VoronDesign/voron-chariot/README.md

# Voron Chariot



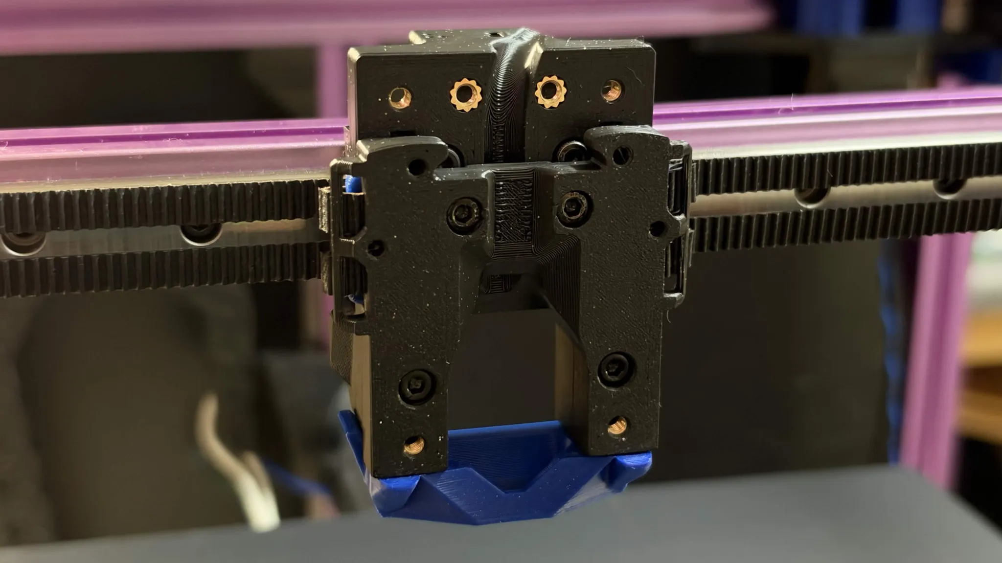
[picture p1: voron_chariot_1.png]
Image of Voron Chariot


The official release of Voron Chariot. You can find the Bill of Materials located [here](BOM.md).

Voron Logo
