VoronDesign/voron-chariot/BOM.md

# Chariot BOM

## Hardware

14 x Brass heat inserts (16 if using BTT Eddy or PINDA)

1 x 100mmx2.5mm Cable/Zip ties

1 x M2x10mm SHCS Self Tapping

2 x M3x6mm BHCS

4 x M3x8mm BHCS (2 if using low profile screws from probe kit)

8 x M3x8mm SHCS

4 x M3x16mm SHCS

2 x M3x20mm BHCS (Only used for BTT Eddy and PINDA)

2 x M3x30mm SHCS

2 x Makerbeam XL T slot nut

2 x M3 Washer

#
