VoronDesign/voron-chariot/CAD/chariot_assembly.step

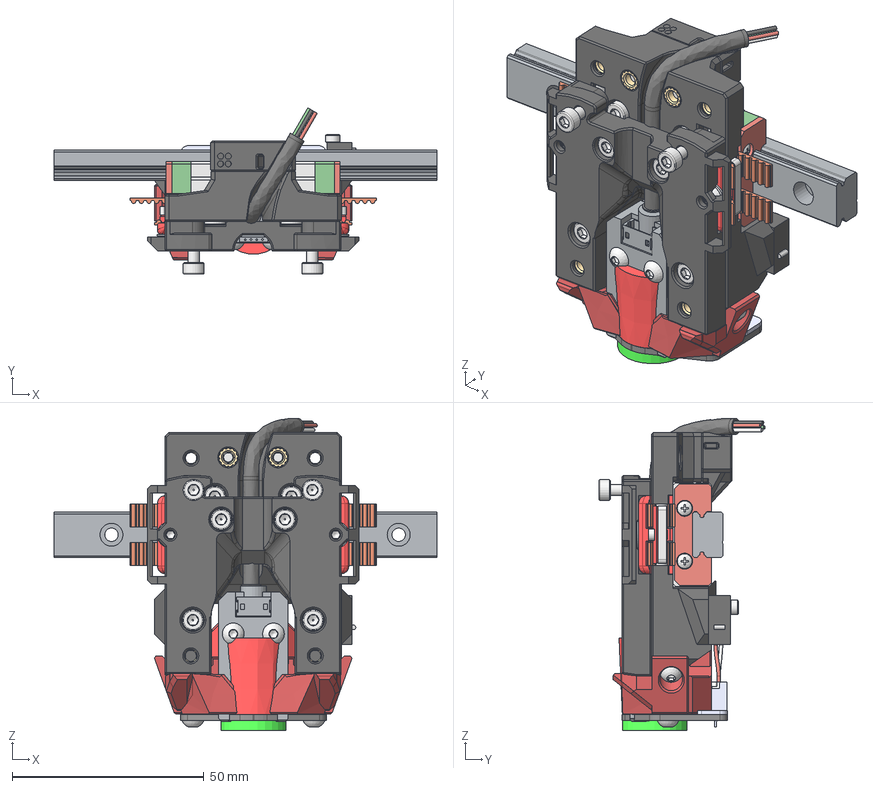
[picture p2: CAD file, 2026-10-30]
CAD/chariot_assembly.step
100.0 x 43.4 x 81.5 mm
belt_section
belt_section001
belt_section002
belt_section003
M3 Threaded Insert x 16
M2x10-SHCS_Self_Tapping
M3x6-BHCS x 2
M3x8-SHCS x 8
M3x8-BHCS x 4
M3x16-SHCS x 4
M3x20-BHCS x 2
M3x30-SHCS x 2
M3-Washer x 2
MakerBeam_XL_T_Slot_Nut x 2
mgn12_carriage001
mgn12_carriage002
mgn12_carriage003
mgn12_carriage004
mgn12_carriage005
mgn12_carriage006
mgn12_carriage007
mgn12_carriage008
mgn12_carriage009
mgn12_rail_100mm
BeaconG_LP
BeaconG_LP001
BeaconG_LP002
BeaconG_LP003
Sherlock Contact
Sherlock Contact001
Sherlock Contact002
Sherlock Contact003
Cable
Cable001
Cable002
Cable003
Cable004
Cable005
Sherlock 4POS Male 2.00MM
BTT_EDDY
PINDA
Wire001
Wire002
manget-6X3 x 3
Omron_D2F_Microswitch_Body
Omron_D2F_Microswitch_Switch
[a]_belt_clip x 2
[a]_belt_clip_insert x 2
carriage_clamp_00i
carriage_clamp_02i
carriage_clamp_04i
carriage_clamp_06i
carriage_clamp_08i
carriage_clamp_10i
[a]_probe_mount_eddy_current
[a]_probe_mount_generic
[a]_probe_mount_klicky
[a]_pinda_adapter
main_carriage_mount
front_plate
