VoronDesign/voron-chariot/STLs/main_carriage_mount.stl

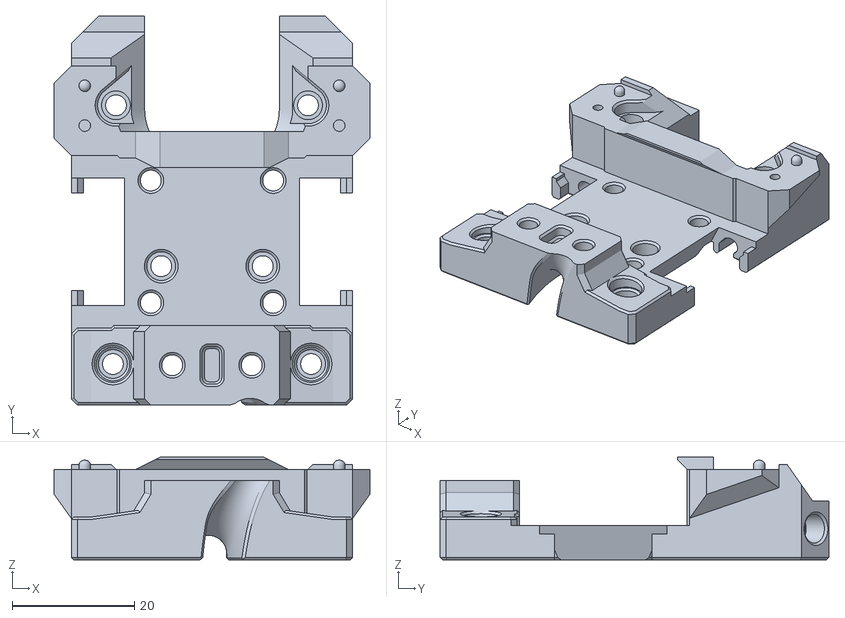
[picture p3: CAD file, 2026-10-29]
STLs/main_carriage_mount.stl
51.6 x 63.6 x 16.8
