VoronDesign/voron-chariot/CAD/native_assembly/chariot_assembly.FCStd

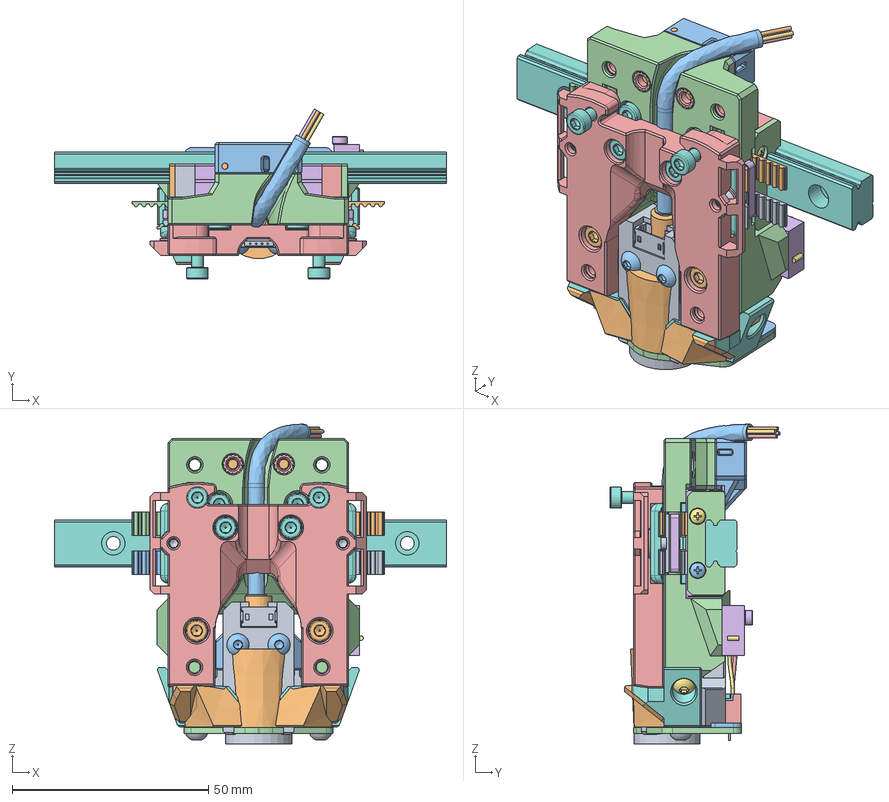
[picture p4: CAD file, 2026-10-30]
CAD/native_assembly/chariot_assembly.FCStd
100.0 x 43.4 x 81.5 mm
belt_section x 3
belt_section001 x 3
belt_section002 x 3
belt_section003 x 3
M3 Threaded Insert x 64
M2x10-SHCS_Self_Tapping x 3
M3x6-BHCS x 6
M3x8-SHCS x 24
M3x8-BHCS x 12
M3x16-SHCS x 12
M3x20-BHCS x 6
M3x30-SHCS x 6
M3-Washer x 6
MakerBeam_XL_T_Slot_Nut x 6
mgn12_carriage001 x 3
mgn12_carriage002 x 3
mgn12_carriage003 x 3
mgn12_carriage004 x 3
mgn12_carriage005 x 3
mgn12_carriage006 x 3
mgn12_carriage007 x 3
mgn12_carriage008 x 3
mgn12_carriage009 x 3
mgn12_rail_100mm x 3
BeaconG_LP x 3
BeaconG_LP001 x 3
BeaconG_LP002 x 3
BeaconG_LP003 x 3
Sherlock Contact x 3
Sherlock Contact001 x 3
Sherlock Contact002 x 3
Sherlock Contact003 x 3
Cable x 3
Cable001 x 3
Cable002 x 3
Cable003 x 3
Cable004 x 3
Cable005 x 3
Sherlock 4POS Male 2.00MM x 3
BTT_EDDY x 3
PINDA x 3
Wire001 x 4
Wire002 x 4
manget-6X3 x 12
Omron_D2F_Microswitch_Body x 3
Omron_D2F_Microswitch_Switch x 3
[a]_belt_clip x 6
[a]_belt_clip_insert x 6
carriage_clamp_00i x 3
carriage_clamp_02i x 3
carriage_clamp_04i x 3
carriage_clamp_06i x 3
carriage_clamp_08i x 3
carriage_clamp_10i x 3
[a]_probe_mount_eddy_current x 3
[a]_probe_mount_generic x 3
[a]_probe_mount_klicky x 3
[a]_pinda_adapter x 3
main_carriage_mount x 2
front_plate x 2
