VoronDesign/voron-chariot/CAD/native_assembly/parametric_probe_mount_eddy_current.FCStd

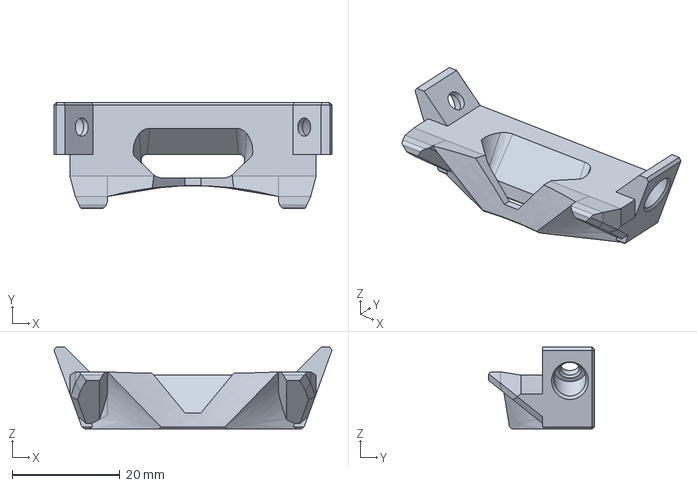
[picture p5: CAD file, 2026-10-30]
CAD/native_assembly/parametric_probe_mount_eddy_current.FCStd
51.6 x 19.6 x 15.2 mm
