VoronDesign/voron-chariot/STLs/carriage_clamps/carriage_clamp_06i.stl

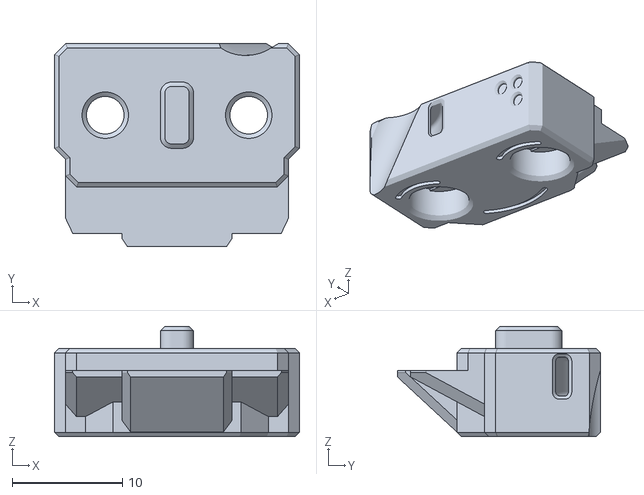
[picture p6: CAD file, 2026-10-29]
STLs/carriage_clamps/carriage_clamp_06i.stl
22.2 x 18.4 x 10.0
