VoronDesign/voron-chariot/STLs/probe_mounts/[a]_probe_mount_generic.stl

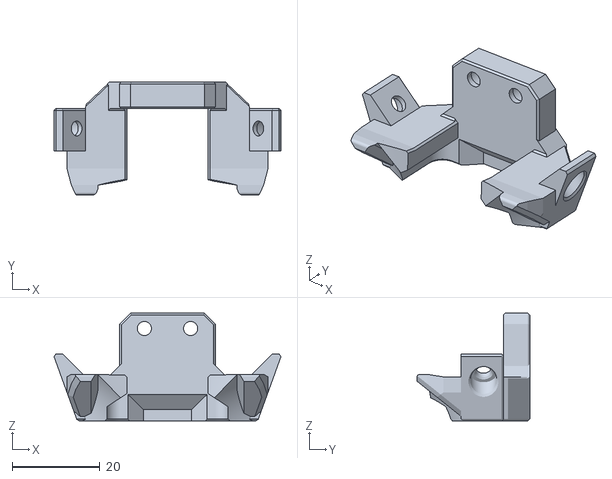
[picture p7: CAD file, 2026-10-30]
STLs/probe_mounts/[a]_probe_mount_generic.stl
51.6 x 25.6 x 24.5
