VoronDesign/voron-chariot/STLs/[a]_belt_clip.stl

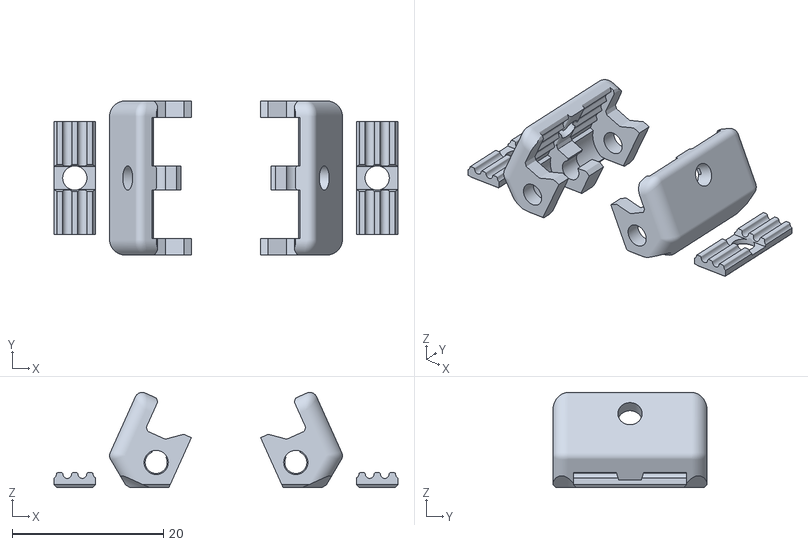
[picture p8: CAD file, 2026-10-29]
STLs/[a]_belt_clip.stl
45.5 x 20.4 x 12.6
