VoronDesign/voron-chariot/STLs/probe_mounts/[a]_probe_mount_pinda_adapter.stl

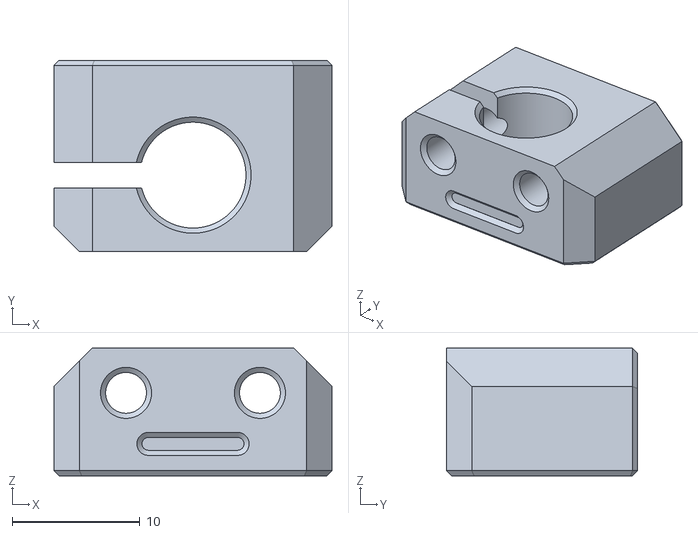
[picture p9: CAD file, 2026-10-29]
STLs/probe_mounts/[a]_probe_mount_pinda_adapter.stl
21.8 x 15.0 x 10.0
