VoronDesign/voron-chariot/STLs/front_plate.stl

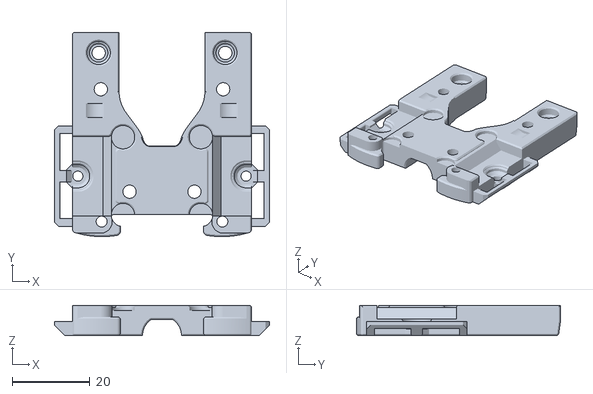
[picture p10: CAD file, 2026-10-29]
STLs/front_plate.stl
55.2 x 52.4 x 7.80
