VoronDesign/voron-chariot/CAD/native_assembly/parametric_probe_mount_klicky.FCStd

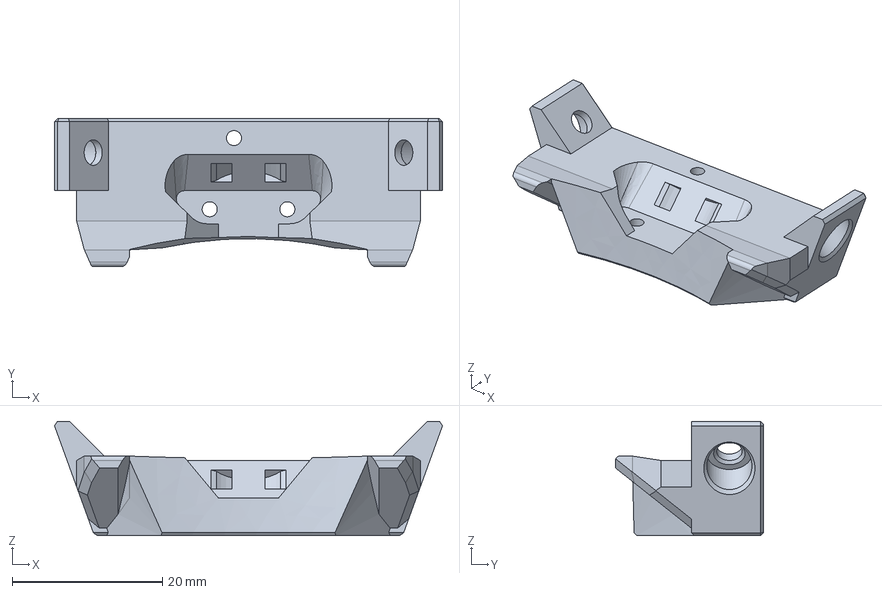
[picture p11: CAD file, 2026-10-30]
CAD/native_assembly/parametric_probe_mount_klicky.FCStd
51.6 x 19.7 x 15.2 mm
