VoronDesign/voron-chariot/STLs/[a]_belt_clip_adhesion_helper.stl

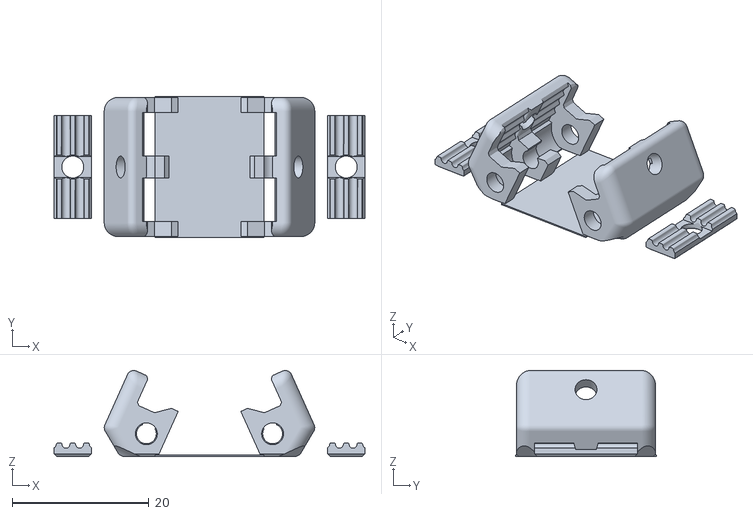
[picture p12: CAD file, 2026-10-29]
STLs/[a]_belt_clip_adhesion_helper.stl
45.5 x 20.6 x 12.6
