VoronDesign/voron-chariot/STLs/probe_mounts/[a]_probe_mount_klicky.stl

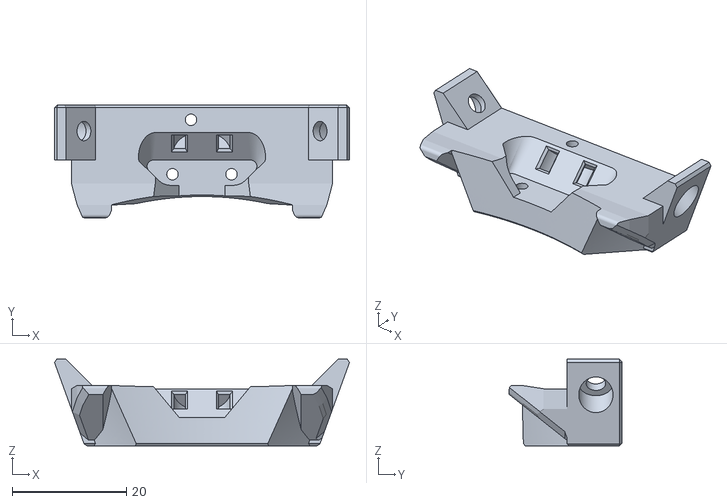
[picture p13: CAD file, 2026-10-29]
STLs/probe_mounts/[a]_probe_mount_klicky.stl
51.6 x 19.7 x 15.2
