VoronDesign/voron-chariot/(list of files, cad)

Other CAD files:
CAD/native_assembly/parametric_probe_mount_generic.FCStd
STLs/carriage_clamps/carriage_clamp_04i.stl
STLs/carriage_clamps/carriage_clamp_10i.stl
STLs/probe_mounts/[a]_probe_mount_eddy_current.stl
STLs/carriage_clamps/carriage_clamp_02i.stl
STLs/carriage_clamps/carriage_clamp_08i.stl
STLs/carriage_clamps/carriage_clamp_00i.stl
