VoronDesign/voron-chariot/(commit log)

2026-10-29 Initial upload
    [[a]_belt_clip_adhesion_helper_x2.stl, [a]_belt_clip_x2.stl, [a]_probe_mount_btt_eddy.stl, [a]_probe_mount_eddy_current.stl, [a]_probe_mount_klicky.stl, [a]_probe_mount_pinda_adapter.stl, carriage_clamp_00i.stl, carriage_clamp_02i.stl]
2026-10-29 Upload CAD
    [chariot_assembly.FCStd, chariot_assembly.step, parametric_probe_mounts.FCStd]
2026-10-30 update CAD
    [[a]_probe_mount_btt_eddy.stl, [a]_probe_mount_generic.stl, chariot_assembly.FCStd, chariot_assembly.step, parametric_probe_mount_eddy_current.FCStd, parametric_probe_mount_generic.FCStd, parametric_probe_mount_klicky.FCStd, parametric_probe_mounts.FCStd]
